Elipsit/ext-WLED-Pixie/Pics/2-top_sidebyside.jpeg

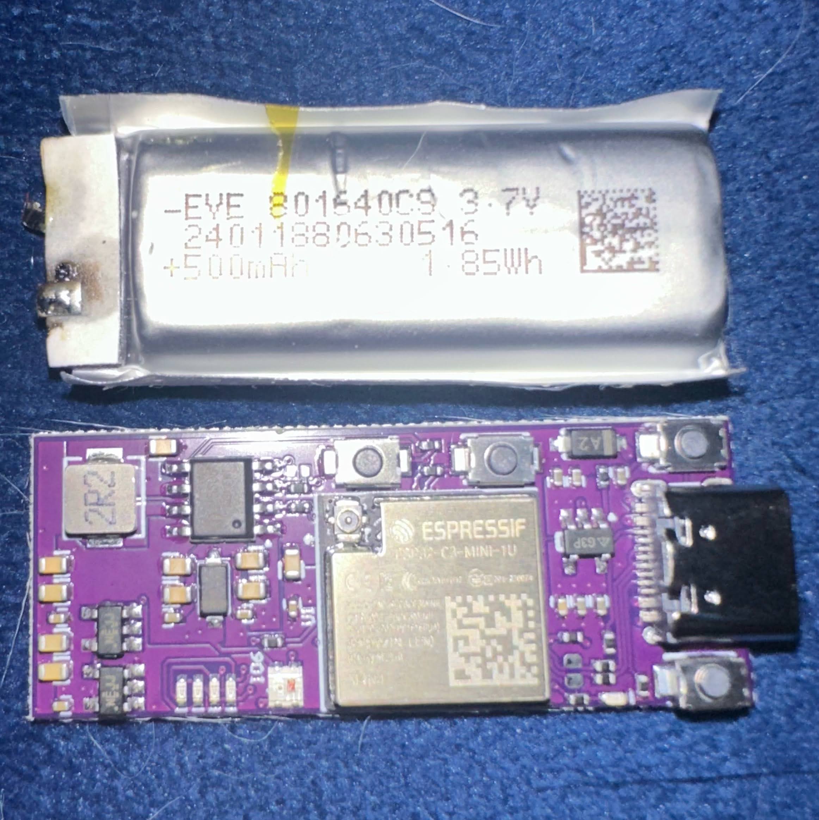
Pics/2-top_sidebyside.jpeg
