Elipsit/ext-WLED-Pixie/WLED_Pixie_Rev_A/Project Outputs for WLED_Pixie_Rev_A/PDF/WLED_Pixie_Rev_A-2024-10-12.PDF

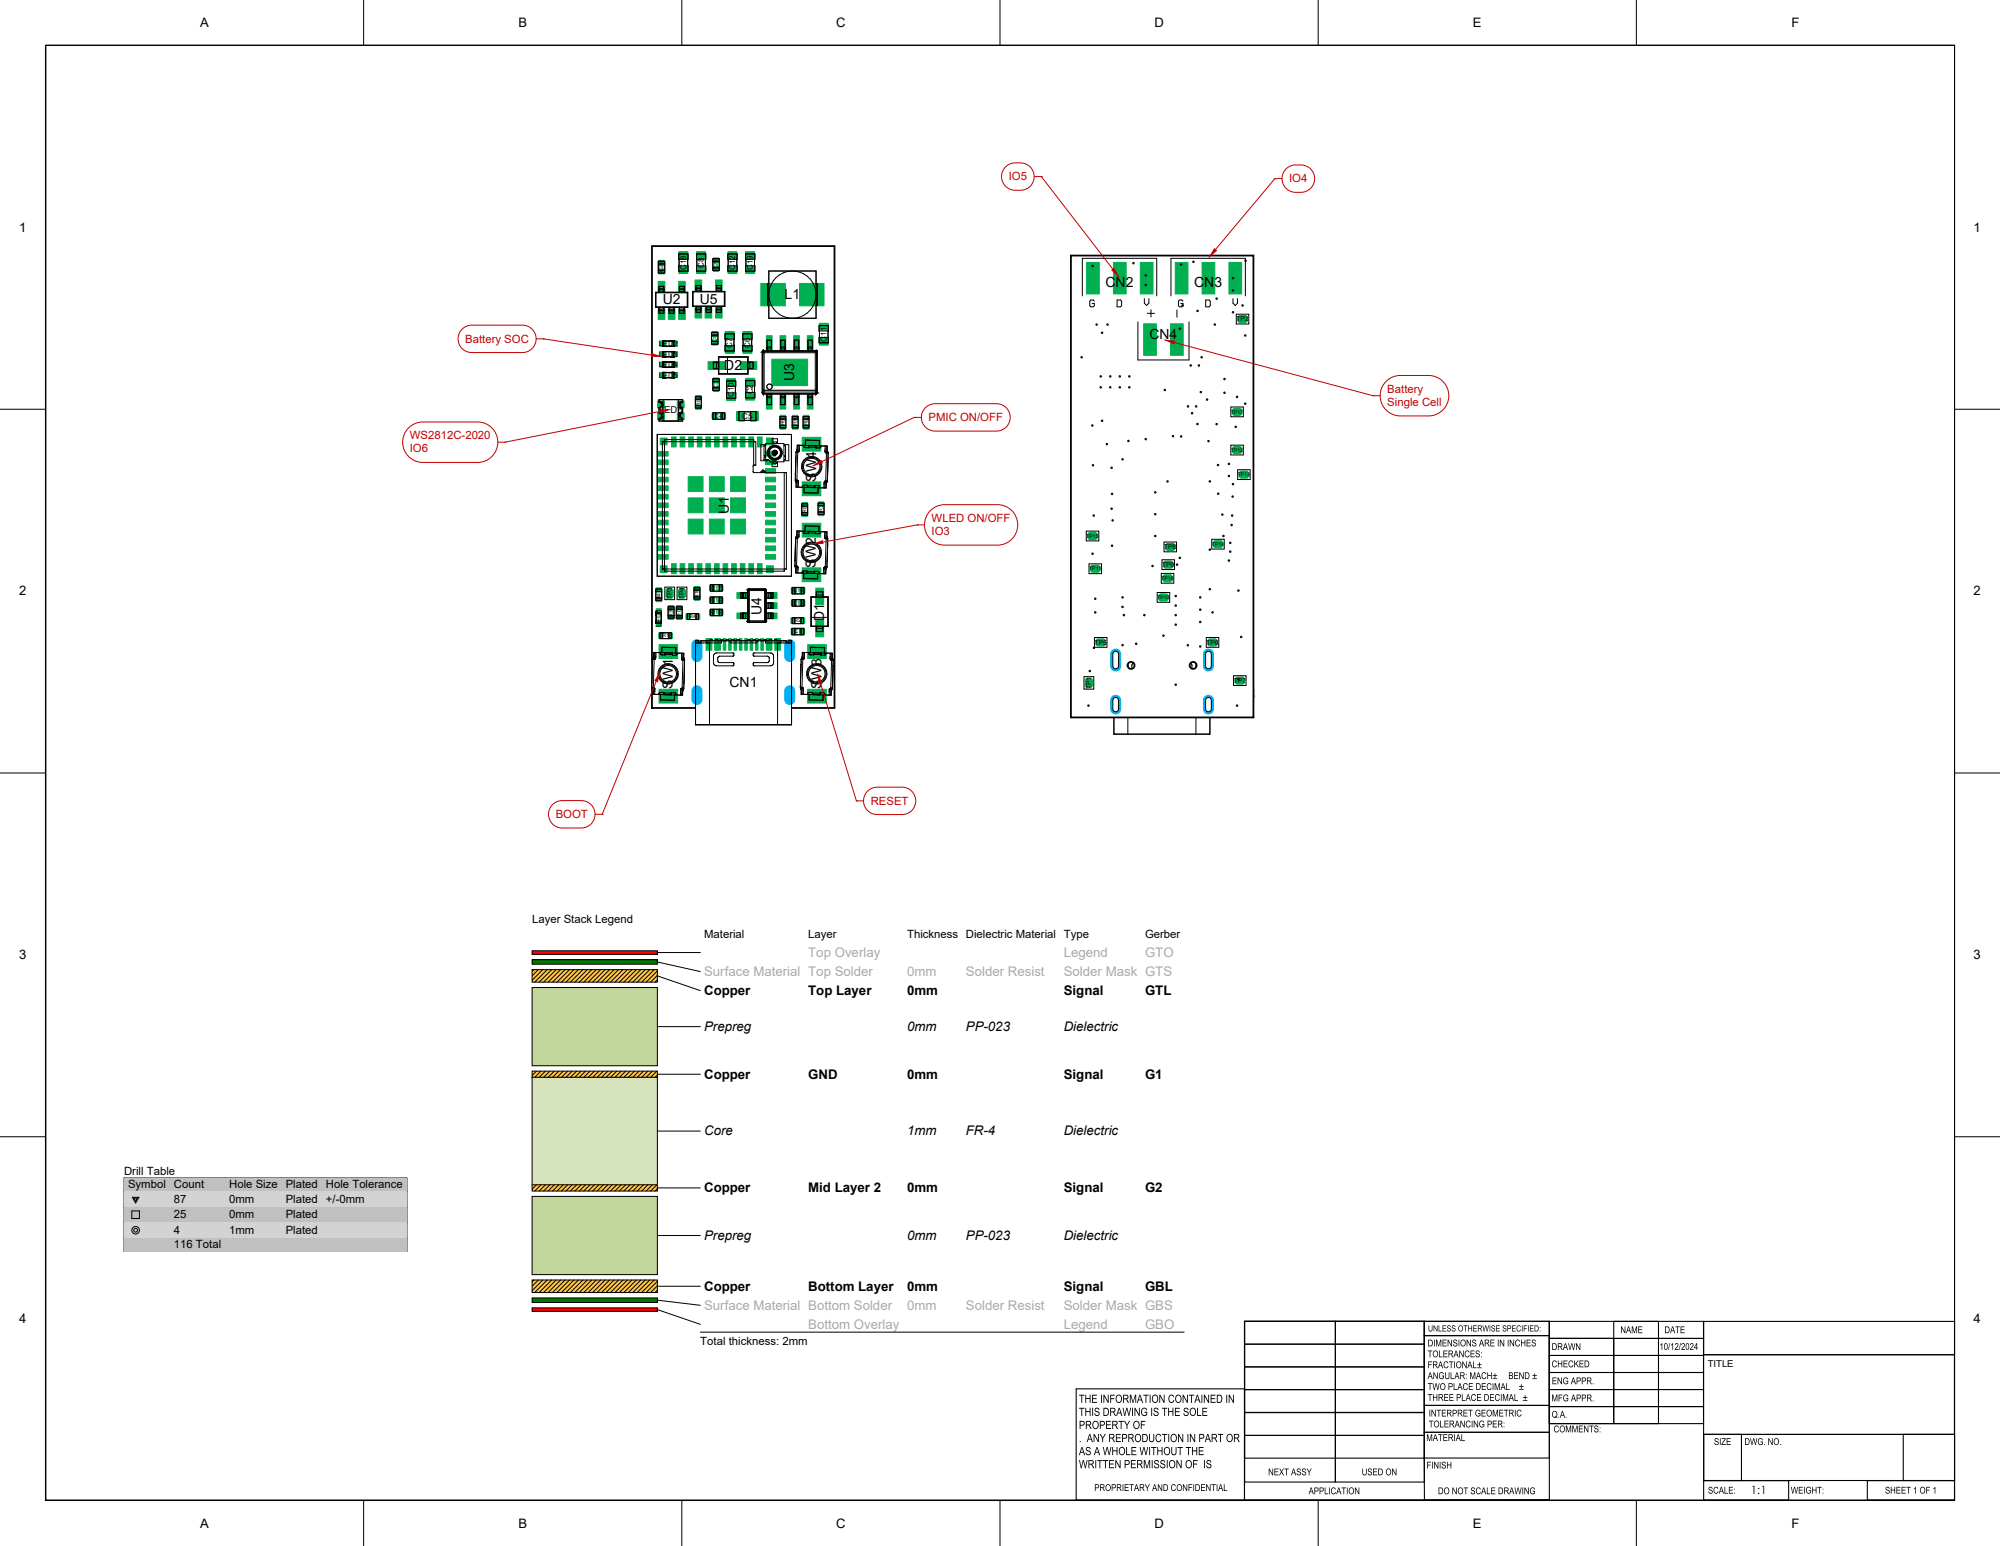
[picture p10: page 2]
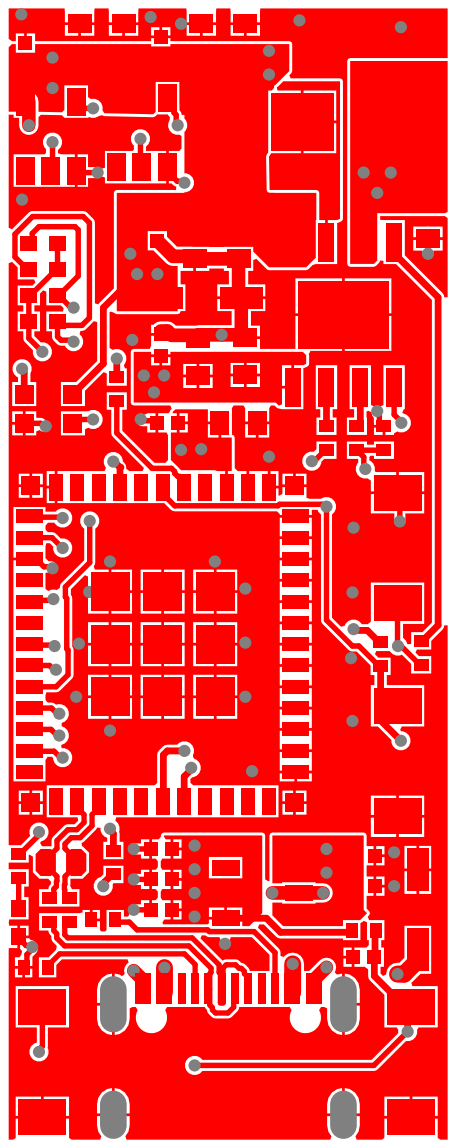
[picture p11: page 3]
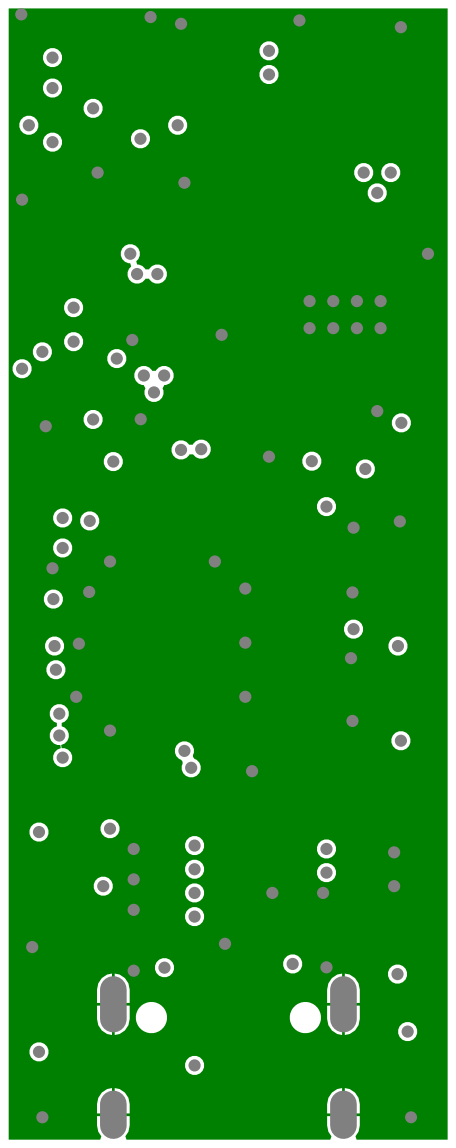
[picture p12: page 4]
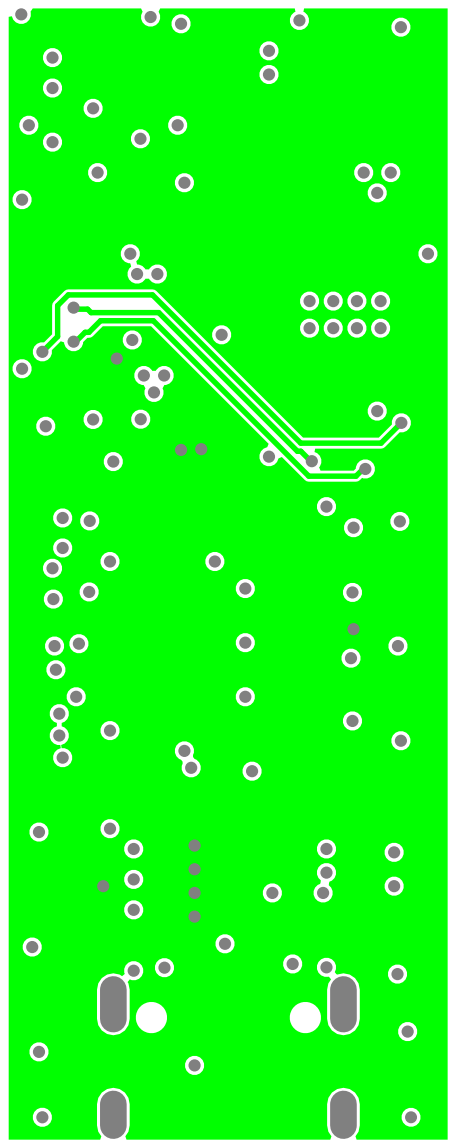
[picture p13: page 5]
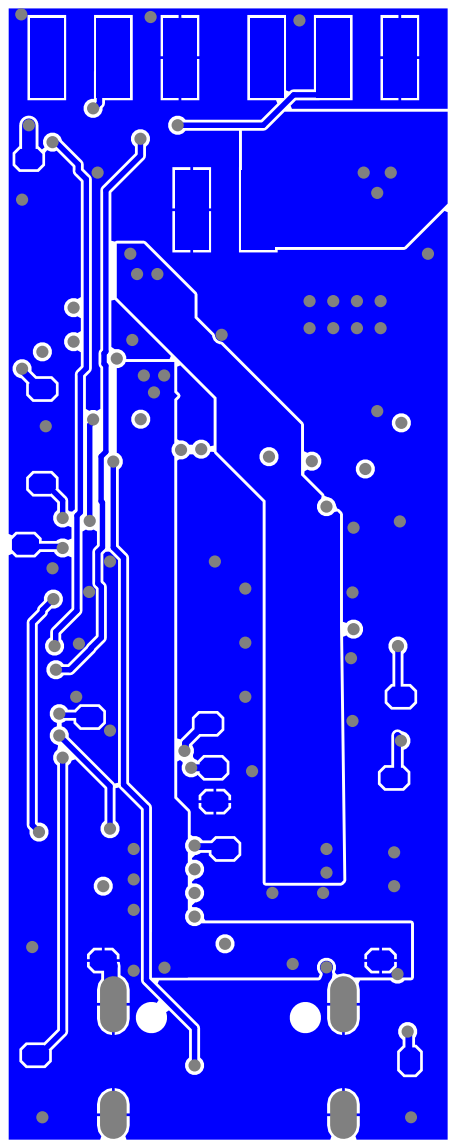
[picture p14: page 6]
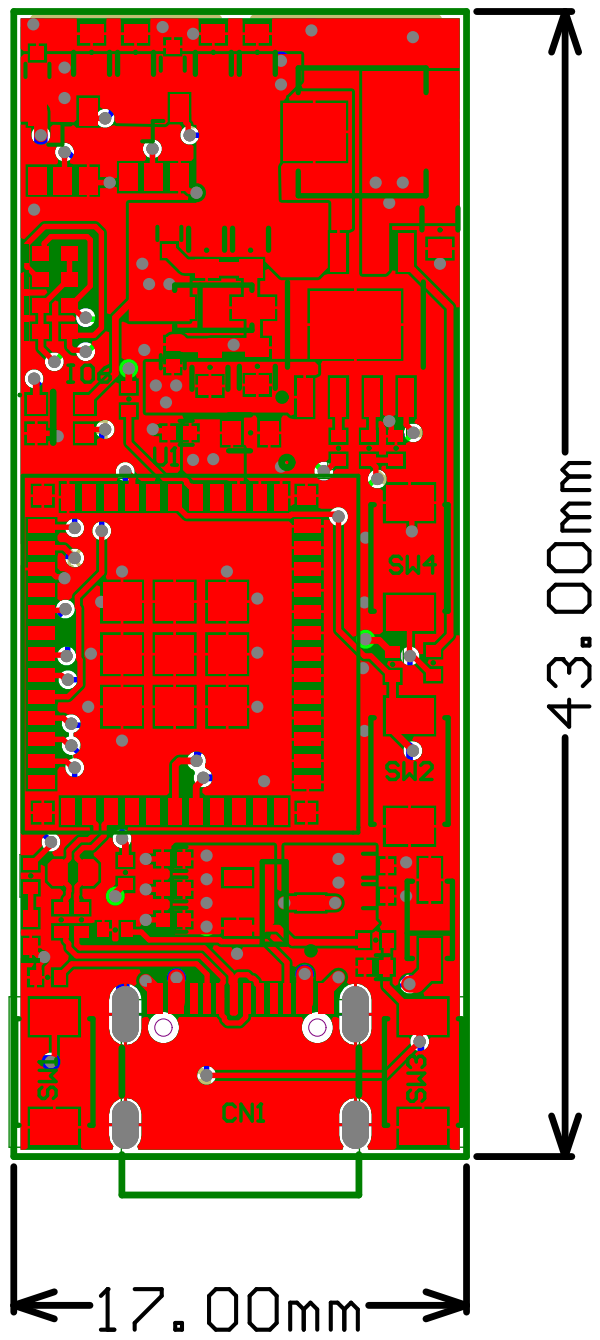
[picture p15: page 7]
