Elipsit/ext-WLED-Pixie/WLED_Pixie_Rev_A/Project Outputs for WLED_Pixie_Rev_A/PDF/WLED_Pixie_Rev_A-2024-10-12.PDF

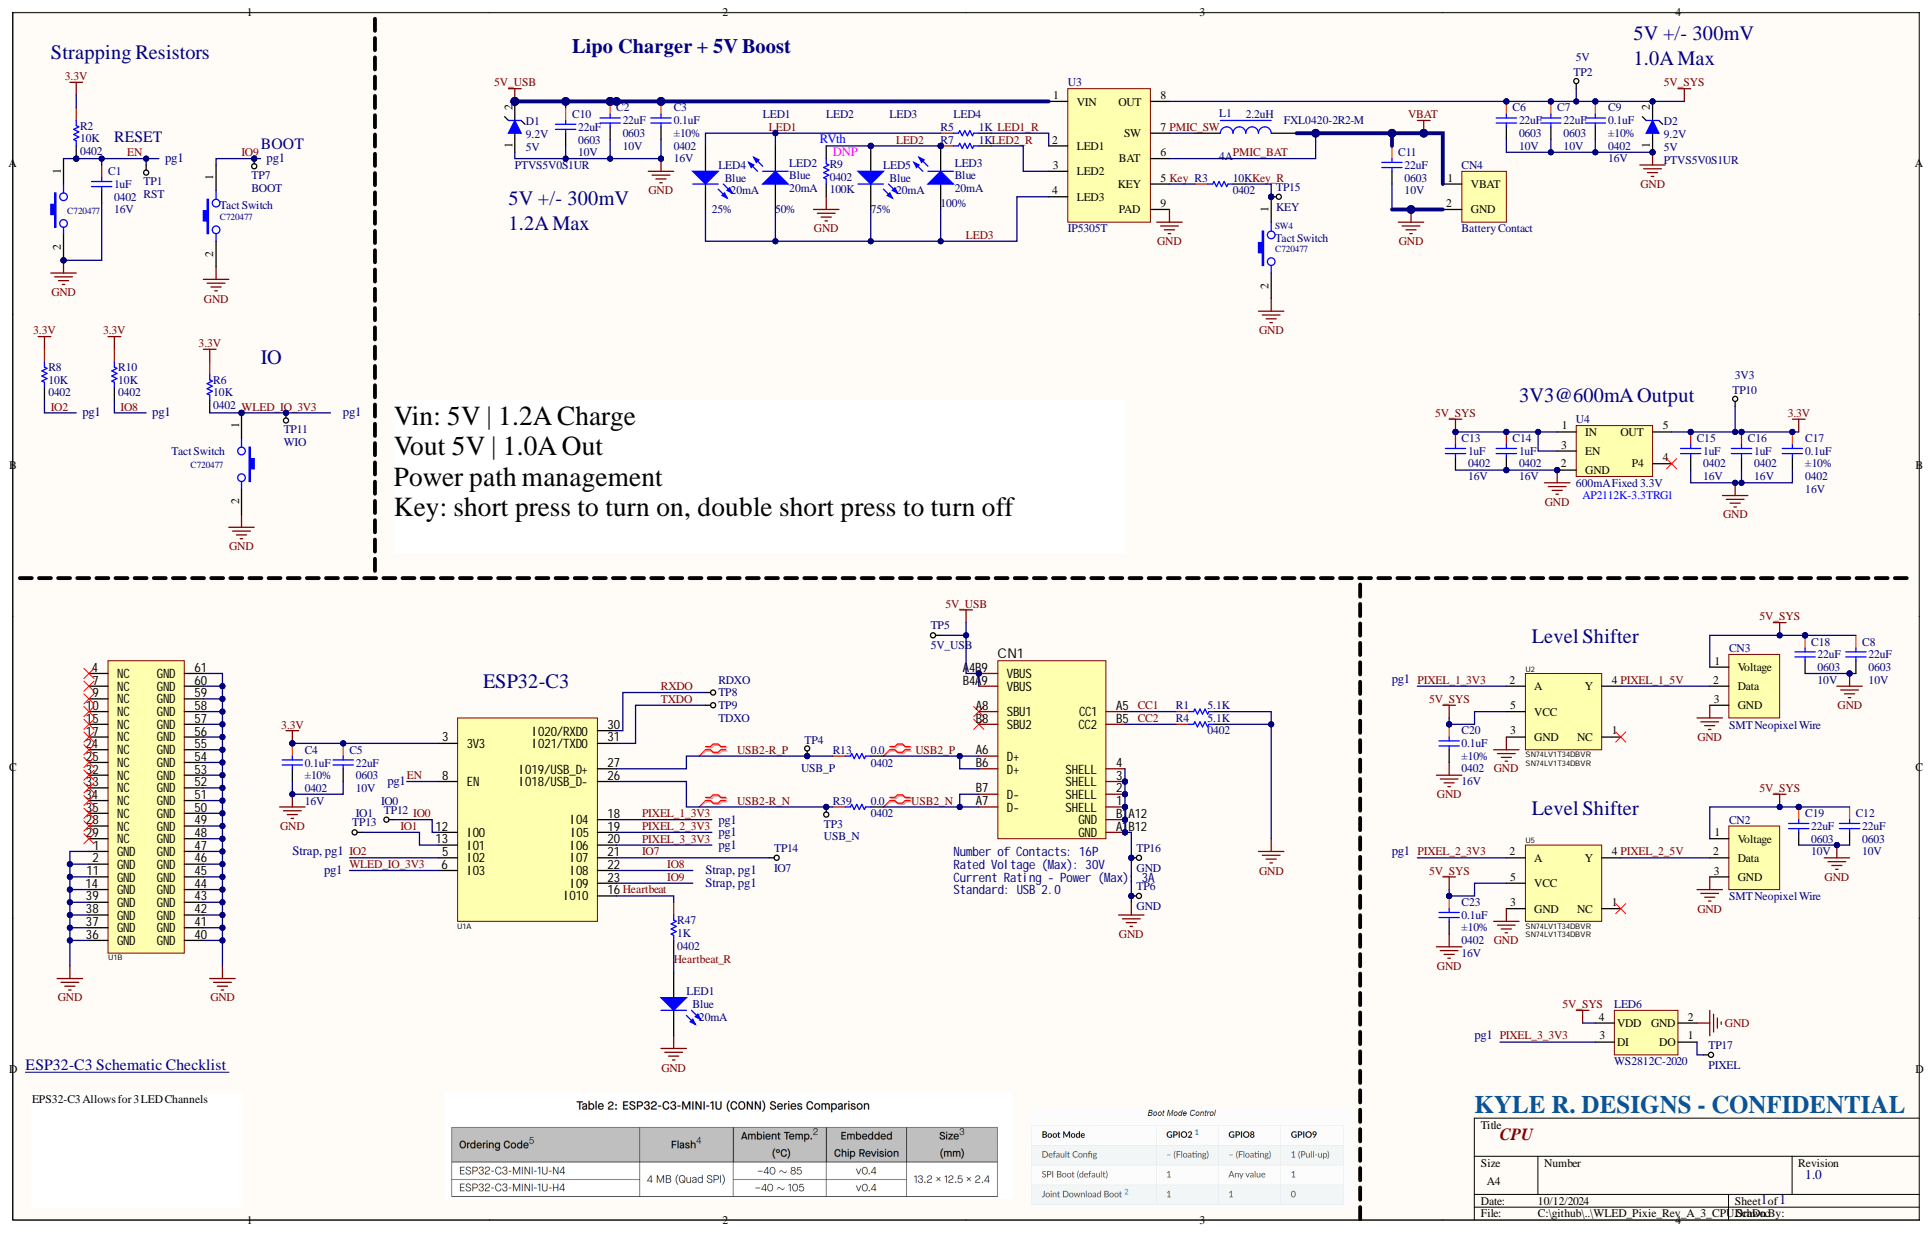
[picture p9: page 1]

LED2 3

Vin: 5V | 1.2A Charge
Vout 5V | 1.0A Out
Power path management
Key: short press to turn on, double short press to turn off

0402 | 0402 | GND 2

Number of Contacts: 16P Rated Voltage (Max): 30V

Current Rating - Power (Max): 3A
Standard: USB 2.0

Size A4 | Number | Revision 1.0

Date: 10/12/2024 | Sheet of 1 1
File: C:\github\..\WLED_Pixie_Rev_A_3_CPU.DScrhawDon cBy:
